s117/OpenPiton-ZC706/piton/design/chipset/mc/rtl/mc_top.v

// ========== Copyright Header Begin ============================================
// Copyright (c) 2015 Princeton University
// All rights reserved.
// 
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
// THIS SOFTWARE IS PROVIDED BY PRINCETON UNIVERSITY "AS IS" AND
// ANY EXPRESS OR IMPLIED WARRANTIES, INCLUDING, BUT NOT LIMITED TO, THE IMPLIED
// WARRANTIES OF MERCHANTABILITY AND FITNESS FOR A PARTICULAR PURPOSE ARE
// DISCLAIMED. IN NO EVENT SHALL PRINCETON UNIVERSITY BE LIABLE FOR ANY
// DIRECT, INDIRECT, INCIDENTAL, SPECIAL, EXEMPLARY, OR CONSEQUENTIAL DAMAGES
// (INCLUDING, BUT NOT LIMITED TO, PROCUREMENT OF SUBSTITUTE GOODS OR SERVICES;
// LOSS OF USE, DATA, OR PROFITS; OR BUSINESS INTERRUPTION) HOWEVER CAUSED AND
// ON ANY THEORY OF LIABILITY, WHETHER IN CONTRACT, STRICT LIABILITY, OR TORT
// (INCLUDING NEGLIGENCE OR OTHERWISE) ARISING IN ANY WAY OUT OF THE USE OF THIS
// SOFTWARE, EVEN IF ADVISED OF THE POSSIBILITY OF SUCH DAMAGE.
// ========== Copyright Header End ============================================

`include "define.vh"
`include "mc_define.h"

module mc_top (
    output                          mc_ui_clk_sync_rst,
    input                           core_ref_clk,

    input   [`NOC_DATA_WIDTH-1:0]   mc_flit_in_data,
    input                           mc_flit_in_val,
    output                          mc_flit_in_rdy,

    output  [`NOC_DATA_WIDTH-1:0]   mc_flit_out_data,
    output                          mc_flit_out_val,
    input                           mc_flit_out_rdy,

    input                           uart_boot_en,

    input                           sys_clk,

    output [`DDR3_ADDR_WIDTH-1:0]   ddr_addr,
    output [`DDR3_BA_WIDTH-1:0]     ddr_ba,
    output                          ddr_cas_n,
    output [`DDR3_CK_WIDTH-1:0]     ddr_ck_n,
    output [`DDR3_CK_WIDTH-1:0]     ddr_ck_p,
    output [`DDR3_CKE_WIDTH-1:0]    ddr_cke,
    output                          ddr_ras_n,
    output                          ddr_reset_n,
    output                          ddr_we_n,
    inout  [`DDR3_DQ_WIDTH-1:0]     ddr_dq,
    inout  [`DDR3_DQS_WIDTH-1:0]    ddr_dqs_n,
    inout  [`DDR3_DQS_WIDTH-1:0]    ddr_dqs_p,
`ifndef NEXYSVIDEO_BOARD
    output [`DDR3_CS_WIDTH-1:0]     ddr_cs_n,
`endif // endif NEXYSVIDEO_BOARD
    output [`DDR3_DM_WIDTH-1:0]     ddr_dm,
    output                          ddr_odt,

    output                          init_calib_complete_out,
    input                           sys_rst_n
);
reg     [31:0]          delay_cnt;
reg                     ui_clk_syn_rst_delayed;
wire                    init_calib_complete;
wire                    afifo_rst_1;
wire                    afifo_rst_2;

 wire                                      app_en;
 wire    [`MIG_APP_CMD_WIDTH-1 :0]         app_cmd;
 wire    [`MIG_APP_ADDR_WIDTH-1:0]         app_addr;
 wire                                      app_rdy;
 wire                                      app_wdf_wren;
 wire    [`MIG_APP_DATA_WIDTH-1:0]         app_wdf_data;
 wire    [`MIG_APP_MASK_WIDTH-1:0]         app_wdf_mask;
 wire                                      app_wdf_rdy;
 wire                                      app_wdf_end;
 wire    [`MIG_APP_DATA_WIDTH-1:0]         app_rd_data;
 wire                                      app_rd_data_end;
 wire                                      app_rd_data_valid;

 wire                                      core_app_en;
 wire    [`MIG_APP_CMD_WIDTH-1 :0]         core_app_cmd;
 wire    [`MIG_APP_ADDR_WIDTH-1:0]         core_app_addr;
 wire                                      core_app_rdy;
 wire                                      core_app_wdf_wren;
 wire    [`MIG_APP_DATA_WIDTH-1:0]         core_app_wdf_data;
 wire    [`MIG_APP_MASK_WIDTH-1:0]         core_app_wdf_mask;
 wire                                      core_app_wdf_rdy;
 wire                                      core_app_wdf_end;
 wire    [`MIG_APP_DATA_WIDTH-1:0]         core_app_rd_data;
 wire                                      core_app_rd_data_end;
 wire                                      core_app_rd_data_valid;


wire                                      app_sr_req;
wire                                      app_ref_req;
wire                                      app_zq_req;
wire                                      app_sr_active;
wire                                      app_ref_ack;
wire                                      app_zq_ack;
wire                                      ui_clk;
wire                                      ui_clk_sync_rst;

reg afifo_ui_rst_r;
reg afifo_ui_rst_r_r;

reg ui_clk_sync_rst_r;
reg ui_clk_sync_rst_r_r;

// needed for correct rst of async fifo
always @(posedge core_ref_clk) begin
    if (~sys_rst_n)
        delay_cnt <= 32'h1ff;
    else begin
        delay_cnt <= (delay_cnt != 0) & ~ui_clk_sync_rst_r_r ? delay_cnt - 1 : delay_cnt;
    end
end

always @(posedge core_ref_clk) begin
    if (ui_clk_sync_rst)
        ui_clk_syn_rst_delayed <= 1'b1;
    else begin
        ui_clk_syn_rst_delayed <= delay_cnt != 0;
    end
end

assign mc_ui_clk_sync_rst   = ui_clk_syn_rst_delayed;

assign init_calib_complete_out = init_calib_complete & ~ui_clk_syn_rst_delayed;
assign afifo_rst_1 = ui_clk_syn_rst_delayed;


always @(posedge ui_clk) begin
    afifo_ui_rst_r <= afifo_rst_1;
    afifo_ui_rst_r_r <= afifo_ui_rst_r;
end


always @(posedge core_ref_clk) begin
    ui_clk_sync_rst_r   <= ui_clk_sync_rst;
    ui_clk_sync_rst_r_r <= ui_clk_sync_rst_r;
end

assign afifo_rst_2 = afifo_ui_rst_r_r | ui_clk_sync_rst;

// TODO: zeroed based on example simulation of MIG7
assign app_ref_req = 1'b0;
assign app_sr_req = 1'b0;
assign app_zq_req = 1'b0;

 wire                              trans_fifo_val;
 wire    [`NOC_DATA_WIDTH-1:0]     trans_fifo_data;
 wire                              trans_fifo_rdy;

 wire                              fifo_trans_val;
 wire    [`NOC_DATA_WIDTH-1:0]     fifo_trans_data;
 wire                              fifo_trans_rdy;

noc_bidir_afifo  mig_afifo  (
    .clk_1           (core_ref_clk      ),
    .rst_1           (afifo_rst_1       ),

    .clk_2           (ui_clk            ),
    .rst_2           (afifo_rst_2       ),

    // CPU --> MIG
    .flit_in_val_1   (mc_flit_in_val    ),
    .flit_in_data_1  (mc_flit_in_data   ),
    .flit_in_rdy_1   (mc_flit_in_rdy    ),

    .flit_out_val_2  (fifo_trans_val    ),
    .flit_out_data_2 (fifo_trans_data   ),
    .flit_out_rdy_2  (fifo_trans_rdy    ),

    // MIG --> CPU
    .flit_in_val_2   (trans_fifo_val    ),
    .flit_in_data_2  (trans_fifo_data   ),
    .flit_in_rdy_2   (trans_fifo_rdy    ),

    .flit_out_val_1  (mc_flit_out_val   ),
    .flit_out_data_1 (mc_flit_out_data  ),
    .flit_out_rdy_1  (mc_flit_out_rdy   )
);

pkt_trans_dp_wide    #  (
    .MIG_APP_ADDR_WIDTH (`MIG_APP_ADDR_WIDTH        ),
    .MIG_APP_DATA_WIDTH (`MIG_APP_DATA_WIDTH        )
)   pkt_trans_dp_wide   (
    .clk                (ui_clk                     ),  // from MC
    .rst                (ui_clk_sync_rst            ),  // from MC

    .uart_boot_en       (uart_boot_en               ),

    .flit_in            (fifo_trans_data            ),
    .flit_in_val        (fifo_trans_val             ),
    .flit_in_rdy        (fifo_trans_rdy             ),
    .flit_out           (trans_fifo_data            ),
    .flit_out_val       (trans_fifo_val             ),
    .flit_out_rdy       (trans_fifo_rdy             ),

    .app_rdy            (core_app_rdy               ),
    .app_wdf_rdy        (core_app_wdf_rdy           ),
    .app_rd_data        (core_app_rd_data           ),
    .app_rd_data_end    (core_app_rd_data_end       ),
    .app_rd_data_valid  (core_app_rd_data_valid     ),
    .phy_init_done      (init_calib_complete        ),

    .app_wdf_wren_reg   (core_app_wdf_wren          ),
    .app_wdf_data_out   (core_app_wdf_data          ),
    .app_wdf_mask_out   (core_app_wdf_mask          ),
    .app_wdf_end_out    (core_app_wdf_end           ),
    .app_addr_out       (core_app_addr              ),
    .app_en_reg         (core_app_en                ),
    .app_cmd_reg        (core_app_cmd               )
);

assign app_en                   = core_app_en;
assign app_cmd                  = core_app_cmd;
assign app_addr                 = core_app_addr;
assign app_wdf_wren             = core_app_wdf_wren;
assign app_wdf_data             = core_app_wdf_data;
assign app_wdf_mask             = core_app_wdf_mask;
assign app_wdf_end              = core_app_wdf_end;
assign core_app_rdy             = app_rdy;
assign core_app_wdf_rdy         = app_wdf_rdy;
assign core_app_rd_data_valid   = app_rd_data_valid;
assign core_app_rd_data_end     = app_rd_data_end;
assign core_app_rd_data         = app_rd_data;


mig_7series_0   mig_7series_0 (
    // Memory interface ports
`ifndef NEXYS4DDR_BOARD
    .ddr3_addr                      (ddr_addr),
    .ddr3_ba                        (ddr_ba),
    .ddr3_cas_n                     (ddr_cas_n),
    .ddr3_ck_n                      (ddr_ck_n),
    .ddr3_ck_p                      (ddr_ck_p),
    .ddr3_cke                       (ddr_cke),
    .ddr3_ras_n                     (ddr_ras_n),
    .ddr3_reset_n                   (ddr_reset_n),
    .ddr3_we_n                      (ddr_we_n),
    .ddr3_dq                        (ddr_dq),
    .ddr3_dqs_n                     (ddr_dqs_n),
    .ddr3_dqs_p                     (ddr_dqs_p),
`ifndef NEXYSVIDEO_BOARD
    .ddr3_cs_n                      (ddr_cs_n),
`endif // endif NEXYSVIDEO_BOARD
    .ddr3_dm                        (ddr_dm),
    .ddr3_odt                       (ddr_odt),
`else // ifdef NEXYS4DDR_BOARD
    .ddr2_addr                      (ddr_addr),
    .ddr2_ba                        (ddr_ba),
    .ddr2_cas_n                     (ddr_cas_n),
    .ddr2_ck_n                      (ddr_ck_n),
    .ddr2_ck_p                      (ddr_ck_p),
    .ddr2_cke                       (ddr_cke),
    .ddr2_ras_n                     (ddr_ras_n),
    .ddr2_we_n                      (ddr_we_n),
    .ddr2_dq                        (ddr_dq),
    .ddr2_dqs_n                     (ddr_dqs_n),
    .ddr2_dqs_p                     (ddr_dqs_p),
    .ddr2_cs_n                      (ddr_cs_n),
    .ddr2_dm                        (ddr_dm),
    .ddr2_odt                       (ddr_odt),
`endif // endif NEXYS4DDR_BOARD

    .init_calib_complete            (init_calib_complete),

    // Application interface ports
    .app_addr                       (app_addr),
    .app_cmd                        (app_cmd),
    .app_en                         (app_en),
    .app_wdf_data                   (app_wdf_data),
    .app_wdf_end                    (app_wdf_end),
    .app_wdf_wren                   (app_wdf_wren),
    .app_rd_data                    (app_rd_data),
    .app_rd_data_end                (app_rd_data_end),
    .app_rd_data_valid              (app_rd_data_valid),
    .app_rdy                        (app_rdy),
    .app_wdf_rdy                    (app_wdf_rdy),
    .app_sr_req                     (app_sr_req),
    .app_ref_req                    (app_ref_req),
    .app_zq_req                     (app_zq_req),
    .app_sr_active                  (app_sr_active),
    .app_ref_ack                    (app_ref_ack),
    .app_zq_ack                     (app_zq_ack),
    .ui_clk                         (ui_clk),
    .ui_clk_sync_rst                (ui_clk_sync_rst),
    .app_wdf_mask                   (app_wdf_mask),

    // System Clock Ports
    .sys_clk_i                      (sys_clk),
    .sys_rst                        (sys_rst_n)
);


`ifdef PITON_PROTO
`ifndef PITON_PROTO_NO_MON

    always @(posedge ui_clk) begin
        if (app_en) begin
            $display("MC_TOP: command to MIG. Addr: 0x%x, cmd: 0x%x at", app_addr, app_cmd, $time);
        end

        if (app_wdf_wren) begin
            $display("MC_TOP: writing data 0x%x to memory at", app_wdf_data, $time);
        end

        if (app_rd_data_valid) begin
            $display("MC_TOP: read data 0x%x from memory at", app_rd_data, $time);
        end
    end

`endif  // PITON_PROTO_NO_MON
`endif  // PITON_PROTO

endmodule 
