s117/OpenPiton-ZC706/piton/design/chip/tile/fpu/rtl/fpu_add_exp_dp.v

// Modified by Princeton University on June 9th, 2015
// ========== Copyright Header Begin ==========================================
// 
// OpenSPARC T1 Processor File: fpu_add_exp_dp.v
// Copyright (c) 2006 Sun Microsystems, Inc.  All Rights Reserved.
// DO NOT ALTER OR REMOVE COPYRIGHT NOTICES.
// 
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
// ========== Copyright Header End ============================================
///////////////////////////////////////////////////////////////////////////////
//
//	Add pipeline exponent datapath.
//
///////////////////////////////////////////////////////////////////////////////


module fpu_add_exp_dp (
	inq_in1,
	inq_in2,
	inq_op,
	inq_op_7,
	a1stg_step,
	a1stg_faddsubd,
	a1stg_faddsubs,
	a1stg_fsdtoix,
	a6stg_step,
	a1stg_fstod,
	a1stg_fdtos,
	a1stg_fstoi,
	a1stg_fstox,
	a1stg_fdtoi,
	a1stg_fdtox,
	a2stg_fsdtoix_fdtos,
	a2stg_faddsubop,
	a2stg_fitos,
	a2stg_fitod,
	a2stg_fxtos,
	a2stg_fxtod,
	a3stg_exp_7ff,
	a3stg_exp_ff,
	a3stg_exp_add,
	a3stg_inc_exp_inv,
	a3stg_same_exp_inv,
	a3stg_dec_exp_inv,
	a3stg_faddsubop,
	a3stg_fdtos_inv,
	a4stg_fixtos_fxtod_inv,
	a4stg_shl_cnt,
	a4stg_denorm_inv,
	a4stg_rndadd_cout,
	add_exp_out_expinc,
	add_exp_out_exp,
	add_exp_out_exp1,
	a4stg_in_of,
	add_exp_out_expadd,
	a4stg_dblop,
	a4stg_to_0_inv,
	fadd_clken_l,
	rclk,
	
	a1stg_expadd3_11,
	a1stg_expadd1_11_0,
	a1stg_expadd4_inv,
	a1stg_expadd2_5_0,
	a2stg_exp,
	a2stg_expadd,
	a3stg_exp_10_0,
	a4stg_exp_11_0,
	add_exp_out,

	se,
	si,
	so
);
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
