s117/OpenPiton-ZC706/(commit log)

2017-08-06 Changed the reset button from GPIO_SW_LEFT to PL_CPU_RESET
2017-08-06 Changed the function led[5] in chipset.v to clk indicator and restored the led[3] to original design. Also modified constraints file to map the port led[5] to GPIO_LED_0
2017-08-06 Downgraded the board_part property of project from 'xilinx.com:zc706:part0:1.4' to 'xilinx.com:zc706:part0:1.2'
2017-09-05 fixed the problem that the SD controller only writes data 0x00 to the card instead of the correct data.
    [sd_wishbone_transaction_manager.v, sm_fifo_rtl.v, spi_master.v]
2017-09-06 changed the implementation to avoid perplexing setup timing fail in L2 cache (the failed paths look like some false paths, but currently just avoid it by doing so)
    [spi_master.v]
2018-01-26 update pin arrangement
