s117/OpenPiton-ZC706/(notices)

Notices in the files:
piton/design/chipset/axi_sd_bridge/rtl/spi_control.v:
Copyright (C) 2008 Steve Fielding and OPENCORES.ORG
piton/design/chipset/axi_sd_bridge/rtl/rwspi_wire_data.v:
Copyright (C) 2004 Steve Fielding and OPENCORES.ORG
